devtank-ltd/kicad_hiltop_84hp_backplane/304-020_Bom_RevA_Iss2.ods

Key
Use same part or better, can use own stock but needs to meet parameters as listed below.
Reference | Quantity | Value | Footprint | Characteristics | Voltage | Manufacturer | Manufacturer Part Number | Alternative Manufacturer | Alternative Manufacturer Part Number | Tolerance
C1, C55 | 2 | 100nF | Capacitor_SMD:C_0402_1005Metric | X5R | 10V
C2, C4, C7, C9, C10, C12, C13, C14, C15, C16, C17, C18, C19, C26, C27, C34, C35, C38, C43, C44, C45, C46, C47, C48, C50, C51, C52, C53 | 28 | 100nF | Capacitor_SMD:C_0402_1005Metric | X5R | 10V
C3, C5 | 2 | 10pF | Capacitor_SMD:C_0402_1005Metric | X5R | 10V
C6, C11 | 2 | 4.7uF | Capacitor_SMD:C_0603_1608Metric | X5R | 10V
C8 | 1 | 3.3uF | Capacitor_SMD:C_0603_1608Metric | X5R | 6.3V
C20, C21, C28, C29, C36, C37 | 6 | 10nF | Capacitor_SMD:C_0402_1005Metric | X5R | 10V
C22, C23, C30, C31 | 4 | 10uF | Capacitor_SMD:C_0603_1608Metric | X5R | 10V
C24, C25, C32, C33, C40, C41, C49 | 7 | 1uF | Capacitor_SMD:C_0603_1608Metric | X5R | 10V
C39, C42 | 2 | 18pF | Capacitor_SMD:C_0603_1608Metric | X5R | 10V
C54 | 1 | 1uF | Capacitor_SMD:C_0402_1005Metric | X5R | 10V
D3, D4 | 2 | LED RED | LED_SMD:LED_0402_1005Metric |  |  | Rohm Semiconductor | SML-P12VTT86R
D14, D16, D18, D20, D22, D24, D26 | 7 | LED GRN | LED_SMD:LED_0402_1005Metric |  |  | Rohm Semiconductor | SML-P13PTT86R
D15, D17, D19, D21, D23, D25, D27 | 7 | LED YEL | LED_SMD:LED_0402_1005Metric |  |  | Rohm Semiconductor | SML-P11MTT86R
F1, F4, F6, F9, F11, F14 | 6 | 1206L075 | Fuse:Fuse_1206_3216Metric |  |  | Littlefuse | 1206L075/13.2WR
F2, F3, F7, F8, F12, F13, F16, F17, F18, F19, F20, F21, F22, F23, F25, F26, F27, F28, F30, F31, F32, F33 | 22 | 1206L050 | Fuse:Fuse_1206_3216Metric |  |  | Littlefuse | 1206L050/15YR
F5, F10, F15, F24, F29, F34 | 6 | 2920L100PR | Fuse:Fuse_2920_7451Metric |  |  | Littlefuse | 2920L100PR
J1, J2, J3, J4, J5, J6 | 6 | CONN_DIN_HDR_96POS | Devtank_PCB_Lib:Socket_DIN41612-CaseC1-full-Female-96Pin-3rows |  |  | Valcon | 406AF-96-FSS-AAB4 |  | 3511396AFSS1BNA1
J7 | 1 | HILTOP_PCIE-64_CONN | Devtank_PCB_Lib:CONN PCI EXP FEMALE 64POS 0.039 |  |  | No part required | No part required
J8 | 1 | PSU1 | Devtank_PCB_Lib:Molex_Mini-Fit_Jr_5566-08A_2x04_P4.20mm_Vertical |  |  | Valcon | 5900-W08ST | Molex | 39-28-1083
J9 | 1 | PSU2 | Devtank_PCB_Lib:Molex_Mini-Fit_Jr_5566-04A_2x02_P4.20mm_Vertical |  |  | Valcon | 5900-W04ST | Molex | 39-28-1043
J10 | 1 | PSU3 | Devtank_PCB_Lib:Molex_Mini-Fit_Jr_5566-02A_2x01_P4.20mm_Vertical |  |  | Valcon | 5900-W02ST | Molex | 39-28-1023
J11 | 1 | SO-DIMM | Devtank_PCB_Lib:Conn_TE-DDR2-SODIMM-0.6-200P-ComputeModule |  |  | Amp-TE | 1565917-4
L2, L3, L4, L5 | 4 | Ferrite_Bead | Inductor_SMD:L_0603_1608Metric |  |  | muRata | BLM18AG121SN1D |  |  | 1%
R1, R2, R3, R58 | 4 | 10K | Resistor_SMD:R_0402_1005Metric |  |  |  |  |  |  | 1%
R4 | 1 | 2.2K | Resistor_SMD:R_0402_1005Metric |  |  |  |  |  |  | 1%
R5, R6, R84, R85, R86, R87, R88, R89, R90, R91 | 10 | 0R | Resistor_SMD:R_0402_1005Metric |  |  |  |  |  |  | 1%
R7 | 1 | 1K | Resistor_SMD:R_0402_1005Metric |  |  |  |  |  |  | 1%
R8 | 1 | 12K | Resistor_SMD:R_0402_1005Metric |  |  |  |  |  |  | 1%
R9, R10, R11, R12, R14, R15 | 6 | 0R | Resistor_SMD:R_0402_1005Metric |  |  |  |  |  |  | 1%
R13, R59 | 2 | DNF | Resistor_SMD:R_0402_1005Metric |  |  |  |  |  |  | 1%
R16, R17, R68, R69, R70, R71, R72, R73, R74, R75, R76, R77, R78, R79, R80, R81 | 16 | 330R | Resistor_SMD:R_0402_1005Metric |  |  |  |  |  |  | 1%
R18, R21, R23, R25, R26, R29 | 6 | DNF | Resistor_SMD:R_0402_1005Metric |  |  |  |  |  |  | 1%
R19, R20, R22, R24, R27, R28 | 6 | 0R | Resistor_SMD:R_0402_1005Metric |  |  |  |  |  |  | 1%
R45, R46, R47 | 3 | 0R | Resistor_SMD:R_1206_3216Metric |  |  |  |  |  |  | 1%
R48 | 1 | 0R | Resistor_SMD:R_0603_1608Metric |  |  |  |  |  |  | 1%
R49 | 1 | 100K | Resistor_SMD:R_0603_1608Metric |  |  |  |  |  |  | 1%
R50, R53, R54, R57 | 4 | 10K | Resistor_SMD:R_0603_1608Metric |  |  |  |  |  |  | 1%
R51 | 1 | 1M | Resistor_SMD:R_0603_1608Metric |  |  |  |  |  |  | 1%
R52 | 1 | 12K | Resistor_SMD:R_0603_1608Metric |  |  |  |  |  |  | 1%
R55, R56 | 2 | DNF | Resistor_SMD:R_0603_1608Metric |  |  |  |  |  |  | 1%
TP1, TP2, TP3, TP4, TP5, TP6, TP7, TP8, TP9, TP10, TP11, TP12, TP13, TP14, TP16, TP17, TP18, TP19, TP20, TP21, TP22, TP23, TP24, TP25, TP26, TP27, TP28, TP29, TP30, TP31 | 30 | TestPoint | TestPoint:TestPoint_THTPad_D1.0mm_Drill0.5mm
TP15 | 1 | +1V8_REG_OUT | TestPoint:TestPoint_THTPad_D1.0mm_Drill0.5mm
U1 | 1 | 93LCxxC | Package_SO:SOIC-8_3.9x4.9mm_P1.27mm |  |  | Microchip | 93LC46B-I/SN
U2 | 1 | FT2232H | Package_DFN_QFN:QFN-64-1EP_9x9mm_P0.5mm_EP7.35x7.35mm |  |  | FTDI | FT2232HQ-REEL
U3, U4 | 2 | LTC4311 | Package_DFN_QFN:DFN-6-1EP_2x2mm_P0.5mm_EP0.61x1.42mm |  |  | Linear Technology | LTC4311CDC
U5 | 1 | USB2517 | Package_DFN_QFN:QFN-64-1EP_9x9mm_P0.5mm_EP4.7x4.7mm |  |  | Microchip | USB2517-JZX
U6, U7 | 2 | LM75B | Package_SO:SOIC-8_3.9x4.9mm_P1.27mm |  |  | NXP | LM75BD,118
Y1 | 1 | ABM10AIG-12.000MHZ-4Z-T3 | Crystal:Crystal_SMD_Abracon_ABM10-4Pin_2.5x2.0mm |  |  | Abracon LLC | ABM10AIG-12.000MHZ-4Z-T3
Y2 | 1 | 24Mhz Xtal | Crystal:Crystal_SMD_Abracon_ABM8G-4Pin_3.2x2.5mm |  |  | AEL Crystals | X24M000000S050 | ECS Inc International | ECS-240-10-33-AGM-TR
