devtank-ltd/kicad_hiltop_84hp_backplane/(commit log)

2017-11-14 Setup common libraries for my Kicad project.
2017-11-14 Setup project for FPGA board
    [DevtankProject.kicad_pcb, DevtankProject.sch]
2017-11-14 Add Ronaks project to git
    [QSPI_Flash.sch, SO-DIMM_200_Connector.sch, SRAM_16bit.sch, USB_FTDI.sch, Xtal_Bias_Test.sch, iCE40_FPGA_Module.sch, ice40-hx8K_breakout_brd.kicad_pcb, ice40-hx8K_breakout_brd.sch]
2017-11-17 USB to FTDI partial schematic
    [QSPI_Flash.sch, SO-DIMM_200_Connector.sch, SRAM_16bit.sch, USB_FTDI.sch, Xtal_Bias_Test.sch, iCE40_FPGA_Module.sch, ice40-hx8K_breakout_brd.sch]
2017-11-30 FTDI, iCE40 chip differential pair schematic
    [QSPI_Flash.sch, SO-DIMM_200_Connector.sch, SRAM_16bit.sch, USB_FTDI.sch, Xtal_Bias_Test.sch, iCE40_FPGA_Module.sch, ice40-hx8K_breakout_brd.sch]
2017-12-07 Added SO-DIMM header, ice40 IO and FTDI power
    [SO-DIMM_200_Connector.sch, SRAM_16bit.sch, USB_FTDI.sch, iCE40_FPGA_Module.sch]
2017-12-07 R/C value updated to FTDI section and also BD port UART logic added
    [USB_FTDI.sch, iCE40_FPGA_Module.sch]
2017-12-11 Add SPI EEPROM logic for SPI switching
    [QSPI_Flash.sch, SO-DIMM_200_Connector.sch, SRAM_16bit.sch, USB_FTDI.sch, Xtal_Bias_Test.sch, iCE40_FPGA_Module.sch]
2017-12-20 global nets changed to hierarchy net, interconnects updated
    [SO-DIMM_200_Connector.sch, SRAM_16bit.sch, USB_FTDI.sch, Xtal_Bias_Test.sch, _saved_ice40-hx8K_breakout_brd.sch, iCE40_FPGA_Module.sch]
2018-01-03 memory modules added
    [Parallel_SRAM.sch, USB_FTDI.sch, Xtal_Bias_Test.sch, _saved_ice40-hx8K_breakout_brd.sch, ice40-hx8K_breakout_brd.sch]
2018-01-08 fix based on feedback and decoupluing caps added
    [Parallel_SRAM.sch, USB_FTDI.sch, ice40-hx8K_breakout_brd.sch]
2018-01-16 post review fix
    [Parallel_SRAM.sch, SRAM_16bit.sch, USB_FTDI.sch, Xtal_Bias_Test.sch, iCE40_FPGA_Module.sch, ice40-hx8K_breakout_brd.sch]
2018-01-17 added shotkey diode to FPGA 1.2V
    [ice40-hx8K_breakout_brd.sch]
2018-01-18 Component Annotated and R/C/Conn/TP CVPCB mapping
    [Parallel_SRAM.sch, SO-DIMM_200_Connector.sch, SRAM_16bit.sch, Xtal_Bias_Test.sch, _saved_USB_FTDI.sch, _saved_iCE40_FPGA_Module.sch, ice40-hx8K_breakout_brd.sch]
2018-01-18 schematic clean up, label aligned
    [Parallel_SRAM.sch, SO-DIMM_200_Connector.sch, SRAM_16bit.sch, USB_FTDI.sch, Xtal_Bias_Test.sch, _saved_USB_FTDI.sch, _saved_iCE40_FPGA_Module.sch, iCE40_FPGA_Module.sch]
2018-04-09 assigned footprint to each component
    [Parallel_SRAM.sch, SO-DIMM_200_Connector.sch, SRAM_16bit.sch, USB_FTDI.sch, Xtal_Bias_Test.sch, iCE40_FPGA_Module.sch, ice40-hx8K_breakout_brd.kicad_pcb, ice40-hx8K_breakout_brd.sch]
2018-04-10 ftdi component placement
    [SO-DIMM_200_Connector.sch, USB_FTDI.sch, Xtal_Bias_Test.sch]
2018-04-11 , diff pair, memory and power component grouping
    [Parallel_SRAM.sch, SO-DIMM_200_Connector.sch, SRAM_16bit.sch, USB_FTDI.sch, Xtal_Bias_Test.sch, iCE40_FPGA_Module.sch, ice40-hx8K_breakout_brd.kicad_pcb, ice40-hx8K_breakout_brd.sch]
2018-04-19 update differential pair connection in schematic and updating layout placement for diff pair
    [Parallel_SRAM.sch, SO-DIMM_200_Connector.sch, SRAM_16bit.sch, USB_FTDI.sch, Xtal_Bias_Test.sch, iCE40_FPGA_Module.sch, ice40-hx8K_breakout_brd.kicad_pcb, ice40-hx8K_breakout_brd.sch]
2018-04-25 Regrouping con't
    [Parallel_SRAM.sch, SO-DIMM_200_Connector.sch, SRAM_16bit.sch, USB_FTDI.sch, Xtal_Bias_Test.sch, iCE40_FPGA_Module.sch, ice40-hx8K_breakout_brd.kicad_pcb, ice40-hx8K_breakout_brd.sch]
2018-05-13 grouping complete ready to route
    [Parallel_SRAM.sch, SO-DIMM_200_Connector.sch, SRAM_16bit.sch, USB_FTDI.sch, Xtal_Bias_Test.sch, _saved_iCE40_FPGA_Module.sch, ice40-hx8K_breakout_brd.kicad_pcb, ice40-hx8K_breakout_brd.sch]
2018-07-31 placement of FTDI and FPGA
    [Parallel_SRAM-2018-07-23-20-06-19.sch, SO-DIMM_200_Connector-2018-07-23-20-06-19.sch, SRAM_16bit-2018-07-23-20-06-19.sch, USB_FTDI-2018-07-23-20-06-19.sch, Xtal_Bias_Test-2018-07-23-20-06-19.sch, iCE40_FPGA_Module-2018-07-23-20-06-19.sch, iCE40_FPGA_Module.sch, ice40-hx8K_breakout_brd-2018-07-23-20-06-19.sch]
2018-12-02 FTDI clean up and USB hub added, SPI logic cleanup
    [Power_Supply.sch, SRAM_16bit.sch, USB_FTDI.sch, backplane_connector.sch, hiltop_backplane_brd.kicad_pcb, hiltop_backplane_brd.sch, ice40-hx8K_breakout_brd.sch, ice40_breakout_brd.sch]
2018-12-05 mother board to backplane connector added, power connector added
    [MotherBoard_Connector.sch, Power_Supply.sch, USB_FTDI.sch, backplane_connector.sch, hiltop_backplane_brd.sch, ice40_breakout_brd.sch]
2018-12-11 root - added pins for SODIMM, added PCI 96 pin connector, pin mapping in progress
    [MotherBoard_Connector.sch, Parallel_SRAM-2018-07-23-20-06-19.sch, Parallel_SRAM.sch, Power_Supply.sch, QSPI_Flash.sch, SO-DIMM_200_Connector-2018-07-23-20-06-19.sch, SO-DIMM_200_Connector.sch, SRAM_16bit-2018-07-23-20-06-19.sch]
2018-12-12 PCI EXPRESS 96
    [MotherBoard_Connector.sch, USB_FTDI.sch, USB_HUB_LED_JUMPERS.sch, backplane_connector.sch, hiltop_backplane_brd.sch, ice40_breakout_brd.sch]
2018-12-12 back plane connector update
    [MotherBoard_Connector.sch, USB_HUB_LED_JUMPERS.sch, backplane_connector.sch, hiltop_backplane_brd.sch, ice40_breakout_brd.sch]
2018-12-18 Added new PCB outline for the backplane
    [MotherBoard_Connector.sch, USB_FTDI.sch, USB_HUB_LED_JUMPERS.sch, backplane_connector.sch, hiltop_backplane_brd.kicad_pcb, hiltop_backplane_brd.sch, ice40_breakout_brd.sch]
2018-12-26 first pass draft for review
    [FPGA_breakout_brd.sch, MotherBoard_Connector.sch, USB_FTDI.sch, USB_HUB_LED_JUMPERS.sch, backplane_connector.sch, hiltop_backplane_brd.sch]
2019-01-03 Schematic updated to reflect USB logic and Global nets changed to local nets, renamed signals in motherboard connector
    [FPGA_breakout_brd.sch, MotherBoard_Connector.sch, USB_HUB_LED_JUMPERS.sch, backplane_connector.sch, hiltop_backplane_brd.sch]
2019-01-09 lables connected to end of net, each component mapped to footprint, working on reducing error
    [FPGA_breakout_brd.sch, MotherBoard_Connector.sch, USB_FTDI.sch, USB_HUB_LED_JUMPERS.sch, backplane_connector.sch, hiltop_backplane_brd.sch]
2019-01-10 schematic error reduced and footprint mapped
    [FPGA_breakout_brd.sch, USB_HUB_LED_JUMPERS.sch, backplane_connector.sch, hiltop_backplane_brd.sch]
2019-01-21 first pass schematic placement
    [MotherBoard_Connector.sch, USB_HUB_LED_JUMPERS.sch, hiltop_backplane_brd.kicad_pcb, hiltop_backplane_brd.sch]
2019-01-25 connector and usb hub routing
    [_saved_hiltop_backplane_brd.sch, hiltop_backplane_brd.kicad_pcb]
2019-01-28 pci connector connection moved to bottom layer, FTDI routing and FPGA power routing
    [FPGA_breakout_brd.sch, USB_HUB_LED_JUMPERS.sch, _saved_hiltop_backplane_brd.sch, backplane_connector.sch, hiltop_backplane_brd.kicad_pcb, hiltop_backplane_brd.sch]
2019-02-04 routing on differential, USB, Power and internconnects
    [backplane_connector.sch, hiltop_backplane_brd.kicad_pcb, hiltop_backplane_brd.sch]
2019-02-06 routing on differential and USB complete
    [hiltop_backplane_brd.kicad_pcb]
2019-02-08 GPIO and differential pair routing update
    [hiltop_backplane_brd.kicad_pcb]
2019-02-10 routing os SODIM and GPIO
    [MotherBoard_Connector.sch, hiltop_backplane_brd.kicad_pcb, hiltop_backplane_brd.sch]
2019-02-11 1st pass layout wihtout GND via's and keep out
    [hiltop_backplane_brd.kicad_pcb]
2019-02-11 via diameter updated and ground vias added
    [hiltop_backplane_brd.kicad_pcb]
2019-02-13 reroute power plane and updated few via's to large size
    [_saved_hiltop_backplane_brd.sch, hiltop_backplane_brd.kicad_pcb]
2019-02-13 converted all the trace via to 0.6mm pad and 0.3mm drill, differential pair exempted
    [hiltop_backplane_brd.kicad_pcb]
2019-02-13 updated power plane
    [hiltop_backplane_brd.kicad_pcb]
2019-02-13 added keepout to differential pair and trace clean up
    [USB_FTDI.sch, _saved_hiltop_backplane_brd.sch, hiltop_backplane_brd.kicad_pcb]
2019-02-13 added ground vias
    [hiltop_backplane_brd.kicad_pcb]
2019-02-14 final design checkin
    [USB_FTDI.sch, hiltop_backplane_brd.kicad_pcb]
2019-02-14 final cleanup
    [hiltop_backplane_brd.kicad_pcb]
2019-02-14 created BOM
2020-02-29 Rev A
    [FPGA_breakout_brd.sch, HILTOP_63HP_Backplane_BOM_RevA.xlsx, HILTOP_63HP_Backplane_BOM_RevB.xlsx, HILTOP_Backplane.kicad_pcb, HILTOP_Backplane.sch, MotherBoard_Connector.sch, USB_FTDI.sch, USB_HUB_LED_JUMPERS.sch]
2021-02-04 add latest changes
    [FPGA_breakout_brd.sch, HILTOP_63HP_Backplane_BOM_RevB.xlsx, HILTOP_Backplane.kicad_pcb, HILTOP_Backplane.sch, MotherBoard_Connector.sch, USB_FTDI.sch, USB_HUB_LED_JUMPERS.sch, backplane_connector.sch]
2021-02-04 started simplifications to design
    [FPGA_breakout_brd.sch, MotherBoard_Connector.sch, USB_FTDI.sch, USB_HUB_LED_JUMPERS.sch, backplane_connector.sch, hiltop_backplane_brd.sch]
2021-02-04 updated FPGA/SOC module pinouts
    [FPGA_breakout_brd.sch, MotherBoard_Connector.sch, USB_FTDI.sch, USB_HUB_LED_JUMPERS.sch, backplane_connector.sch, hiltop_backplane_brd.sch]
2021-02-07 updated schematics to RevC including general tidy up
    [FPGA_breakout_brd.sch, MotherBoard_Connector.sch, USB_FTDI.sch, USB_HUB_LED_JUMPERS.sch, backplane_connector.sch, hiltop_backplane_brd.sch]
2021-02-08 updated backplane connector details
    [HILTOP_63HP_Backplane_BOM_RevB.xlsx, USB_FTDI.sch, hiltop_backplane_brd.sch]
2021-02-08 general update of PCB layout to include thicker power tracks - move from 4 to 6 layers
    [hiltop_backplane_brd.kicad_pcb, hiltop_backplane_brd.sch]
2021-02-09 updated LVDS differential tracking
    [MotherBoard_Connector.sch, backplane_connector.sch, hiltop_backplane_brd.kicad_pcb, hiltop_backplane_brd.sch]
2021-02-09 noticed a fpga_Soc module missing on schematics
    [MotherBoard_Connector.sch]
2021-02-09 Recovered FPGA_SOM Schematics!
    [Parallel_SRAM.sch, iCE40_FPGA_Module.sch, ice40-hx8K_breakout_brd.sch, ice40_breakout_brd.sch]
2021-02-09 updated schematics
    [fpga_soc_module.sch]
2021-02-09 Rev C ready for review - updated CERN license details
    [fpga_soc_module.sch]
2021-02-12 Swapped Y2 for 24MHz crystal
    [USB_HUB_LED_JUMPERS.sch]
2021-02-22 fix to inner ground plane flooding for CM
    [hiltop_backplane_brd.csv]
2021-03-16 Added new files ready for public release
    [FPGA_breakout_brd.sch, HILTOP_63HP_Backplane_BOM_RevA.ods, HILTOP_63HP_Backplane_BOM_RevA.xlsx, HILTOP_63HP_Backplane_BOM_RevB.ods, HILTOP_63HP_Backplane_BOM_RevB.xlsx, HILTOP_63HP_Backplane_BOM_RevC.ods, Parallel_SRAM-2018-07-23-20-06-19.sch, SO-DIMM_200_Connector-2018-07-23-20-06-19.sch]
2023-02-28 First update to schematics for 84hp backplane
    [MotherBoard_Connector.kicad_sch, USB_FTDI.kicad_sch, USB_HUB_LED_JUMPERS.kicad_sch, backplane_connector.kicad_sch, fpga_soc_module.kicad_sch, hiltop_backplane_brd.kicad_sch]
2023-02-28 Renamed to 84h backplane.
    [MotherBoard_Connector.kicad_sch, MotherBoard_Connector.sch, Power_Supply.sch, QSPI_Flash.sch, SO-DIMM_200_Connector.sch, SRAM_16bit.sch, USB_FTDI.kicad_sch, USB_FTDI.sch]
2023-03-01 Updated files path on kicad for devtank symbols and footprints
    [USB_FTDI.kicad_sch, fpga_soc_module.kicad_sch, hiltop_backplane_brd.kicad_sch]
2023-03-01 Updated layout with throwdown, added slots and resized board
    [MotherBoard_Connector.kicad_sch, USB_FTDI.kicad_sch, backplane_connector.kicad_sch, fpga_soc_module.kicad_sch, hiltop_backplane_brd.kicad_sch]
2023-03-03 Started differential tracking on layout
    [backplane_connector.kicad_sch, fpga_soc_module.kicad_sch, hiltop_backplane_brd.kicad_sch]
2023-03-05 added length matching for lvs dp tracks
    [fpga_soc_module.kicad_sch, hiltop_backplane_brd.kicad_sch]
2023-03-13 Added io tracking on the layout
    [USB_FTDI.kicad_sch, USB_HUB_LED_JUMPERS.kicad_sch, backplane_connector.kicad_sch, fpga_soc_module.kicad_sch, hiltop_backplane_brd.kicad_sch]
2023-04-03 finished tracking on board
    [USB_HUB_LED_JUMPERS.kicad_sch, fpga_soc_module.kicad_sch, hiltop_backplane_brd.kicad_sch]
2023-04-05 added matched single length tracks for trig signal
    [fpga_soc_module.kicad_sch]
2023-04-05 added stitching vias
    [USB_FTDI.kicad_sch, USB_HUB_LED_JUMPERS.kicad_sch, backplane_connector.kicad_sch, fpga_soc_module.kicad_sch, hiltop_backplane_brd.kicad_sch]
2023-04-06 Layout finished and gerbers exported
    [HILTOP_63HP_Backplane_BOM_RevA.ods, HILTOP_63HP_Backplane_BOM_RevB.ods, HILTOP_63HP_Backplane_BOM_RevC.ods, MotherBoard_Connector.kicad_sch, USB_FTDI.kicad_sch, USB_HUB_LED_JUMPERS.kicad_sch, backplane_connector.kicad_sch, fpga_soc_module.kicad_sch]
2023-04-06 updated gerber made length of board 0.44mm shorter
    [hiltop_backplane_brd-B_Adhesive.gbr, hiltop_backplane_brd-B_Courtyard.gbr, hiltop_backplane_brd-B_Cu.gbr, hiltop_backplane_brd-B_Mask.gbr, hiltop_backplane_brd-B_Paste.gbr, hiltop_backplane_brd-B_Silkscreen.gbr, hiltop_backplane_brd-Edge_Cuts.gbr, hiltop_backplane_brd-F_Adhesive.gbr]
2023-04-14 added measurments to layout
    [404-020_Bom_RevA.ods, MotherBoard_Connector.kicad_sch, USB_FTDI.kicad_sch, USB_HUB_LED_JUMPERS.kicad_sch, backplane_connector.kicad_sch, fpga_soc_module.kicad_sch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]
2023-04-24 slots replaced with mounting holes and fiducials added
    [MotherBoard_Connector.kicad_sch, USB_FTDI.kicad_sch, USB_HUB_LED_JUMPERS.kicad_sch, backplane_connector.kicad_sch, fpga_soc_module.kicad_sch, hiltop_backplane_brd.kicad_sch]
2023-04-25 moved 12V and power supplies on layout
2023-04-25 usb and lvd lines of layout brought away from mounting holes
2023-05-03 updated layout with mounting holes and better tracking
    [MotherBoard_Connector.kicad_sch, USB_FTDI.kicad_sch, USB_HUB_LED_JUMPERS.kicad_sch, backplane_connector.kicad_sch, fpga_soc_module.kicad_sch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]
2023-05-24 fixed usb2 tracking on layout
    [USB_FTDI.kicad_sch, backplane_connector.kicad_sch, fpga_soc_module.kicad_sch]
2023-05-31 Finished layout and exported gerbers as iss2
    [MotherBoard_Connector.kicad_sch, USB_FTDI.kicad_sch, USB_HUB_LED_JUMPERS.kicad_sch, backplane_connector.kicad_sch, fpga_soc_module.kicad_sch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]
2023-05-31 updated bom for 304-020 Rev A
    [304-020_Bom_RevA_Iss2.ods, 404-020_Bom_RevA.ods, MotherBoard_Connector.kicad_sch, USB_HUB_LED_JUMPERS.kicad_sch, backplane_connector.kicad_sch, fpga_soc_module.kicad_sch]
