devtank-ltd/kicad_hiltop_84hp_backplane/(notices)

Notices in the files:
kicad_hiltop_63hp_backplane/hiltop_backplane_brd.kicad_pcb:
CERN OHL v1.2
